researchanddesire/Open-Source-Wireless-Remote_RADR/hardware/cables/README.md

# RADR Cable Harnesses

Wireviz cable harness source files belong in this folder.

The product-level `hardware/bom.csv` should list each harness or cable as a
top-level assembly/device item. Detailed wire, connector, and child-part BOMs
should come from Wireviz-generated output when a harness source exists.
