researchanddesire/Open-Source-Wireless-Remote_RADR/hardware/cad/README.md

# RADR CAD

Mechanical source files and release exports for RADR belong in this folder.

Current migrated print files live under `hardware/Print Files/`. Future release
CAD exports should be placed here so the Ohai assembly-docs contract has the
standard `hardware/cad/`, `hardware/pcb/`, and `hardware/cables/` source
boundaries.
