researchanddesire/Open-Source-Wireless-Remote_RADR/assembly-docs/pcb-overview.mdx

---
title: PCB Overview
---

The source PCB design files live in [`hardware/pcb/`](https://github.com/researchanddesire/Open-Source-Wireless-Remote_RADR/tree/main/hardware/pcb/). The detailed PCB component BOM is tracked there and linked from the `RADR PCB assembly` line in the [Bill of Materials](/radr/bom).

| Asset | Link |
| ----- | ---- |
| PCB design files | [`hardware/pcb/RADR - PCB Design Files v0.4/`](https://github.com/researchanddesire/Open-Source-Wireless-Remote_RADR/tree/main/hardware/pcb/RADR%20-%20PCB%20Design%20Files%20v0.4/) |
| Board layout | [`PCB - OSSM Wireless v0.4.pcbdoc`](https://github.com/researchanddesire/Open-Source-Wireless-Remote_RADR/blob/main/hardware/pcb/RADR%20-%20PCB%20Design%20Files%20v0.4/PCB%20-%20OSSM%20Wireless%20v0.4.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) |
| Schematic PDF | [`RADR Schematic - OSSM Wireless V0.4.pdf`](https://github.com/researchanddesire/Open-Source-Wireless-Remote_RADR/blob/main/hardware/pcb/RADR%20Schematic%20-%20OSSM%20Wireless%20V0.4.pdf) |
| PCB render | [`RADR PCB render.png`](https://github.com/researchanddesire/Open-Source-Wireless-Remote_RADR/blob/main/hardware/pcb/RADR%20PCB%20render.png) |
| PCB component BOM | [`RADR BOM - OSSM Wireless - v0.4 - S3.xlsx`](https://github.com/researchanddesire/Open-Source-Wireless-Remote_RADR/blob/main/hardware/pcb/RADR%20BOM%20-%20OSSM%20Wireless%20-%20v0.4%20-%20S3.xlsx) |
