researchanddesire/Open-Source-Wireless-Remote_RADR/assembly-docs/pcb-overview.md

# PCB Overview

The source PCB design files live in [`hardware/pcb/`](../hardware/pcb/). The detailed PCB component BOM is tracked there and linked from the `RADR PCB assembly` line in the [Bill of Materials](bom.md).

| Asset | Link |
| ----- | ---- |
| PCB design files | [`hardware/pcb/RADR - PCB Design Files v0.4/`](../hardware/pcb/RADR%20-%20PCB%20Design%20Files%20v0.4/) |
| Board layout | [`PCB - OSSM Wireless v0.4.pcbdoc`](../hardware/pcb/RADR%20-%20PCB%20Design%20Files%20v0.4/PCB%20-%20OSSM%20Wireless%20v0.4.pcbdoc) |
| Schematic PDF | [`RADR Schematic - OSSM Wireless V0.4.pdf`](../hardware/pcb/RADR%20Schematic%20-%20OSSM%20Wireless%20V0.4.pdf) |
| PCB render | [`RADR PCB render.png`](../hardware/pcb/RADR%20PCB%20render.png) |
| PCB component BOM | [`RADR BOM - OSSM Wireless - v0.4 - S3.xlsx`](../hardware/pcb/RADR%20BOM%20-%20OSSM%20Wireless%20-%20v0.4%20-%20S3.xlsx) |
