researchanddesire/Open-Source-Wireless-Remote_RADR/developer-docs/docs/hardware/specifications/index.md

# RADR Hardware Specifications

Technical reference for power behavior, indicators, and feedback.

- [Battery and Power](/radr/hardware/specifications/battery-and-power/)
- [Feedback and Indicators](/radr/hardware/specifications/feedback-and-indicators/)
