researchanddesire/Open-Source-Wireless-Remote_RADR/CUTOVER.md

# Cutover checklist — RADR

RADR is already public under CERN-OHL-S. Cutover replaces the canonical repo with the restructured `RADR-OSS` fork.

Validate OTA at `https://researchanddesire.github.io/RADR-OSS/` before switch.

See [`dev-docs/CUTOVER.md`](https://github.com/researchanddesire/dev-docs/blob/main/CUTOVER.md).
