researchanddesire/Open-Source-Wireless-Remote_RADR/STAGING.md

# OSS staging — RADR-OSS

Canonical **`main`** on `radr-wireless-remote` continues normal development.

```bash
git fetch upstream main
git checkout opensource-prep
git rebase upstream/main
```

Set `upstream` to `https://github.com/researchanddesire/radr-wireless-remote.git`.
