researchanddesire/Open-Source-Wireless-Remote_RADR/developer-docs/docs/development/screen-capture.md

# Development display capture

Development profiles `development` enable the
read-only `screen` command on the normal 115200-baud USB serial port. Production
and staging profiles omit the console, its task and its capture memory.
Existing development aliases retain their behavior.

Build explicitly without uploading, from the repository root:

```sh
pio run -d software/firmware -e development -t buildprog
```

Use the enrolled device and its matching flash/PSRAM profile. Do not replace its
partition layout or erase NVS to take a screenshot. Close other serial monitors
and wait for a hardware-validation job to finish before opening its port. Keep
the device idle (and a Lockbox unlocked).

```sh
python -m pip install pyserial
python software/scripts/capture_screen.py --port COM_PORT --product RADR --output-dir captures --name current
```

Replace COM_PORT with the verified device port. Opening serial can reset some
boards; use `--startup-delay 10` if needed. Omit `--name` to keep one connection
open while navigating normally; type `capture menu` or `quit`. This works on
Windows and with piped commands. A single capture makes at most three requests and times out after 90 seconds. TFT captures take about 12 seconds; the UI continues updating during transmission.

The tool saves a PNG, little-endian RGB565 buffer, and JSON dimensions/checksums.
Rows carry a snapshot ID and RLE pixels; the complete frame must match the
device's FNV-1a checksum. Stale, duplicate or corrupted rows cannot produce an unchecked image. If USB drops bytes or logs
interrupt a transfer, screen retry retransmits the retained snapshot, even while
the UI changes. The reader releases it after success; an abandoned snapshot
expires after 90 seconds. Only snapshots with the same
product, dimensions and complete-image checksum can supply missing rows; the
combined pixels must still pass the checksum. Changed images never mix. Unrelated
device logs are ignored and never saved. Exhausted retries fail without saving.

TFT firmware mirrors drawing operations, including fast bitmap writes, in PSRAM.
OLED firmware copies its existing 1024-byte U8g2 buffer and translates its configured
rotation into the logical UI view. The display mutex is held only while copying;
serial transmission does not pause rendering. Development SDK logs use the
same serial writer to avoid splitting rows; ordinary and fault logs are retained. This captures the current pixel
buffer, not backlight brightness, panel faults, or an optical photograph. It does
not change product control protocols, pairing, calibration or saved credentials.

Do not commit captures: they may show device or account information. PR checks
compile every development variant and test rejection of damaged capture streams;
staging hardware evidence still uses the exact PR staging artifacts.
