researchanddesire/Open-Source-Wireless-Remote_RADR/developer-docs/docs/tools/web-flasher.md

# Web Flasher (RADR)

Use this tool for firmware recovery and manual flashing of your RADR. The Web Flasher runs directly in a Chromium-based browser (Chrome or Edge) and installs firmware over USB-C — no software installation required.

import { DeviceFlasher } from '/snippets/shared/device-flasher.jsx';

<DeviceFlasher />
