researchanddesire/Open-Source-Wireless-Remote_RADR/hardware/Photos/RADR main menu.webp

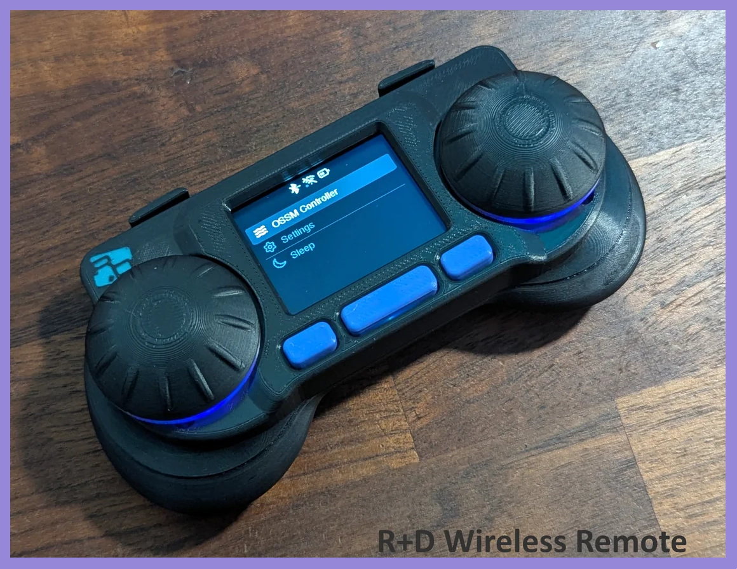
hardware/Photos/RADR main menu.webp
