researchanddesire/Open-Source-Wireless-Remote_RADR/assembly-docs/bom.mdx

---
title: Bill of Materials
showToc: false
---

The RADR wireless remote uses a custom populated PCB assembly, display, battery, 3D-printed enclosure parts, printed controls, weather stripping, and tri-lobe screws.

## Parts

This parts list is generated from [`hardware/bom.csv`](https://github.com/researchanddesire/Open-Source-Wireless-Remote_RADR/blob/main/hardware/bom.csv) during the assembly-docs build. Do not edit the generated table by hand. Update the CSV instead. Parts are referenced throughout the [Assembly Guide](/radr/assembly-guide).

import bom from "./_bom/bom.json";

<BillOfMaterials data={bom} />

## Assembly Tools and Shop Supplies

| Item | Use |
| ---- | --- |
| Rasp | Deburring the PCBA edge before enclosure fit-up. |
| T8 screwdriver bit | Installing tri-lobe enclosure screws. |
| Electric screwdriver or hand driver | Driving enclosure and battery-cover screws. |
| Isopropyl alcohol | Cleaning the PCBA before installing weather stripping. |
| Microfiber cloth | Cleaning the PCBA and protecting cosmetic surfaces. |
| Razor blade | Trimming the front-housing bumper features. |
| Hot glue gun | Securing the display into the front housing. |
| Small screwdriver | Opening the display ribbon connector and cleaning the knob bore. |
