researchanddesire/Open-Source-Wireless-Remote_RADR/developer-docs/docs/hardware/bom.md

# Bill of Materials (BOM)

If you're comfortable with electronics repair and want to source replacement components yourself (such as encoders, switches, or other parts), the Bill of Materials (BOM) contains manufacturer part numbers for all components.

**[RADR Bill of Materials](https://github.com/researchanddesire/Open-Source-Wireless-Remote_RADR/tree/main/hardware)**

Complete parts list with manufacturer part numbers and specifications.

The BOM Excel file (`RADR BOM - OSSM Wireless - v0.4 - S3.xlsx`) includes:

- Manufacturer part numbers
- Component values and specifications
- Quantity per board

!!! tip
    For common components like rotary encoders and tactile switches, you can often find equivalent parts at electronics suppliers like DigiKey, Mouser, or LCSC using the part numbers from the BOM.

If you'd prefer not to source parts yourself, [contact support](mailto:support@researchanddesire.com) and we can send replacement components or a replacement remote.
