researchanddesire/Open-Source-Wireless-Remote_RADR/developer-docs/docs/hardware/printed-parts/index.md

# RADR Printed Parts

Use these pages to identify, print, and troubleshoot each RADR printed component.

- [Remote Top](/radr/hardware/printed-parts/part-by-part/remote-top/)
- [Remote Bottom](/radr/hardware/printed-parts/part-by-part/remote-bottom/)
- [Remote Knob](/radr/hardware/printed-parts/part-by-part/remote-knob/)
- [Buttons](/radr/hardware/printed-parts/part-by-part/buttons/)
- [Power Switch](/radr/hardware/printed-parts/part-by-part/power-switch/)
- [OSSM Remote Clip](/radr/hardware/printed-parts/part-by-part/ossm-remote-clip/)
