researchanddesire/Open-Source-Wireless-Remote_RADR/developer-docs/docs/hardware/printed-parts/part-by-part/power-switch.md

# Power Switch Cap

import { STLViewer } from '/snippets/ossm/stl-render.jsx';

<STLViewer url="https://raw.githubusercontent.com/researchanddesire/Open-Source-Wireless-Remote_RADR/main/hardware/Print%20Files/Power%20Switch.stl" />

## Function

The Power Switch Cap is an optional decorative cover that fits over the power switch toggle. This component:

- Provides an aesthetically finished look to the power switch
- Sits over the existing switch toggle
- Purely cosmetic—not required for operation

## Print Settings

| Setting | Value |
|---|---|
| Layer Height | 0.12mm |
| Walls | 4 |
| Infill Type | Gyroid |
| Infill Percentage | 25% |
| Supports | None |

!!! tip
    This is a very small part. Print multiple copies or include it with other small parts like the buttons for efficiency.

## Installation

### Step 1: Print the cap

  Print the power switch cap using the settings above.

  !!! success
The cap is free of defects and has clean surfaces.

### Step 2: Press onto switch

  Gently press the cap onto the power switch toggle. It should friction-fit in place.

  !!! warning
Do not use adhesive unless the fit is too loose. A drop of CA glue can be used as a last resort.

### Step 3: Test operation

  Verify the switch still operates smoothly with the cap installed.

  !!! success
Switch toggles on/off with no binding or interference.

!!! info
    This part is optional. The remote functions perfectly without it—the power switch is fully usable as-is.

## Download Files
**[STEP File](https://github.com/researchanddesire/Open-Source-Wireless-Remote_RADR/blob/main/hardware/Print%20Files/Power%20Switch.step)**

Download for CAD editing

**[3MF Project](https://github.com/researchanddesire/Open-Source-Wireless-Remote_RADR/blob/main/hardware/Print%20Files/Bambu%20A1%20Remote_V1.01.3mf)**

Bambu Studio project with print settings
