researchanddesire/Open-Source-Wireless-Remote_RADR/developer-docs/docs/hardware/printed-parts/part-by-part/remote-bottom.md

# Remote - Bottom Housing

import { STLViewer } from '/snippets/ossm/stl-render.jsx';

<STLViewer url="https://raw.githubusercontent.com/researchanddesire/radr-wireless-remote/main/Hardware/Print%20Files/Remote%20-%20Bottom.stl" />

## Function

The Bottom Housing is the lower shell of the RADR wireless remote. This component:

- Forms the battery compartment for the rechargeable battery
- Provides the rear ergonomic surface for comfortable grip
- Contains mounting bosses for PCB attachment
- Features the USB-C charging port access
- Mates with the Top Housing to complete the enclosure

## Print Settings

| Setting | Value |
|---|---|
| Layer Height | 0.12mm (for smooth curves) |
| Walls | 4 |
| Infill Type | Gyroid |
| Infill Percentage | 20-30% |
| Supports | Yes - for internal features |

!!! tip
    Print with the interior facing up to ensure clean exterior surfaces.

## Assembly Notes

### Step 1: Check fit

  Test fit the PCB and battery before final assembly. Verify the USB-C port aligns with the housing opening.
  
  !!! success
The PCB sits flat on the mounting bosses with no interference.

### Step 2: Verify clearances

  Ensure the battery fits with adequate clearance. Some printer tolerances may require light sanding.
  
  !!! warning
Do not force components. If fit is too tight, sand lightly rather than applying excessive force.

## Download Files
**[STEP File](https://github.com/researchanddesire/radr-wireless-remote/blob/main/Hardware/Print%20Files/Remote%20-%20Bottom.step)**

Download for CAD editing

**[3MF Project](https://github.com/researchanddesire/radr-wireless-remote/blob/main/Hardware/Print%20Files/Bambu%20A1%20Remote_V1.01.3mf)**

Bambu Studio project with print settings
