researchanddesire/Open-Source-Wireless-Remote_RADR/hardware/pcb/RADR BOM - OSSM Wireless - v0.4 - S3.xlsx

Quantity | Designator | Footprint | Value | Manufacturer Part | Manufacturer
1 | Blue_Charge | LED-SMD_L1.7-W0.6-RD |  | TJ-S1706SW6TGLC6B-A5 | TOGIALED(统佳)
1 | BUZZER1 | BUZ-SMD_L4.0-W4.0-P3.50-L | 4kHz | FUET-4020 | FUET(福声科技)
7 | C6,C8,C23,C24,C25,C26,C35 | C0402 | 10uF | GRM155R61A106ME44D | muRata(村田)
5 | C9,C11,C15,C16,C17 | C0402 | 100nF | CL05A104KA5NNNC | SAMSUNG(三星)
2 | C10,C27 | C0402 | 1uF | CL05A105KA5NQNC | SAMSUNG(三星)
1 | C14 | C0402 | 10uF | CL05A106MP5NUNC | SAMSUNG(三星)
3 | C18,C19,C20 | C0402 | 2.2uF | CL05A225KO5NQNC | SAMSUNG(三星)
5 | C28,C29,C30,C32,C33 | C1206 | 100uF | GRM31CR60J107ME39L | muRata(村田)
1 | C34 | C0402 | 10nF | CC0402KRX7R5BB103 | YAGEO(国巨)
2 | D1,D2 | SOD-123F_L2.7-W1.6-LS3.8-RD-1 |  | B5819W | GOODWORK(固得沃克)
1 | D3 | SOD-123_L2.8-W1.8-LS3.7-RD |  | B5819W-TP | MCC(美微科)
2 | ENC_L,ENC_R | SW-TH_EC12EXXXX |  | EC12E24204A8 | ALPSALPINE(阿尔卑斯阿尔派)
3 | ESP,External,Internal | SOT-23-5_L3.0-W1.7-P0.95-LS2.8-BL |  | ME6211C33M5G-N | MICRONE(南京微盟)
1 | Green_Power | LED-SMD_L1.7-W0.6-RD |  | TJ-S1706SW6TGLC2G-A5 | TOGIALED(统佳)
5 | LS_1,LS_2,RESET,RS_1,RS_2 | SW-SMD_TS24CA |  | TS24CA | SHOU HAN(首韩)
1 | M1 | VIBRATING-MOTOR-SMD_3P-C9900001680 |  | Z3OC1T8219731 | KOTL(金龙机电)
2 | P-UP-1,P-UP-2 | SW-SMD_2P-L6.2-W2.5-LS9.4 |  | 2.54-1P TPGT | SHOU HAN(首韩)
1 | POWERSW | SW-TH_SK12D07VG5 |  | SK12D07VG5 | SHOU HAN(首韩)
3 | Q1,Q2,Q3 | SOT-23_L2.9-W1.3-P1.90-LS2.4-BR |  | AO3400 | GOODWORK(固得沃克)
2 | Q5,Q6 | SOT-23-3_L2.9-W1.3-P1.90-LS2.4-BR |  | BC817 | CJ（江苏长电/长晶）
1 | Q7 | SOT-23-3_L2.9-W1.4-P1.91-LS2.6-BR |  | SI2301 | TWGMC(台湾迪嘉)
1 | QWIIC | CONN-SMD_4P-P1.00_SM04B-SRSS-TB-LF-SN |  | SM04B-SRSS-TB(LF)(SN) | JST
1 | R1 | R0603 | 10Ω | PS03W4F100JT5E | UNI-ROYAL(厚声)
3 | R7,R8,R26 | R0402 | 10kΩ | WR04X1002FTL | 华新科(Walsin)
2 | R9,R10 | R0402 | 100Ω | RC0402FR-07100RL | YAGEO(国巨)
2 | R11,R16 | R0402 | 1kΩ | RC0402FR-071KL | YAGEO(国巨)
1 | R18 | R0402 | 2kΩ | RC0402FR-072KL | YAGEO(国巨)
1 | R19 | R0402 | 330Ω | RC0402FR-07330RL | YAGEO(国巨)
2 | R20,R21 | R0402 | 5.1kΩ | 0402WGF5101TCE | UNI-ROYAL(厚声)
8 | R22,R23,R24,R25,R32,R35,R36,R39 | R0402 | 10kΩ | RC0402FR-0710KL | YAGEO(国巨)
1 | R34 | R0402 | 5.1kΩ | RC0402FR-075K1L | YAGEO(国巨)
2 | R40,R41 | R0402 | 4.7kΩ | 0402WGJ0472TCE | UNI-ROYAL(厚声)
1 | SCREEN | FPC-SMD_AFC01-S14FCA-00 |  | AFC01-S14FCA-00 | JS(钜硕电子)
3 | U1,U2,U3 | LED-SMD_4P-L1.0-W1.0-TL_XL-1010RGBC-WS2812B |  | XL-1010RGBC-WS2812B | XINGLIGHT(成兴光)
1 | U5 | LGA-14_L3.0-W2.5-P0.50-TL |  | LSM6DS3TR-C | ST(意法半导体)
1 | U6 | SOT-23-5_L3.0-W1.7-P0.95-LS2.8-BL |  | TP4054-42-SOT25R | TOPPOWER(南京拓微)
1 | U8 | CONN-TH_S2B-PH-K-LF-SN |  | S2B-PH-K(LF)(SN) | JST
1 | U9 | WQFN-28_L5.0-W5.0-P0.50-BL-EP3.2 |  | CP2102-GMR | SILICON LABS(芯科)
1 | U14 | DFN-8_L2.0-W2.0-P0.50-BL-EP |  | MAX17048G+T10 | ADI(亚德诺)/MAXIM(美信)
1 | U15 | WIRELM-SMD_ESP32-S3-WROOM-1 |  | ESP32-S3-WROOM-1-N16R8 | ESPRESSIF(乐鑫)
1 | U16 | SOIC-8_L5.0-W4.0-P1.27-LS6.0-BL |  | AT24C04C-SSHM-T | MICROCHIP(美国微芯)
1 | USBC1 | USB-C_SMD-TYPE-C-31-M-12 |  | TYPE-C-31-M-12 | 韩国韩荣
4 | US_L,US_M_1,US_M_2,US_R | SW-TH_4P-L5.0-W5.0-P4.50-LS6.5 |  | TC-6610-9-260G | HCTL(华灿天禄)
