researchanddesire/Open-Source-Wireless-Remote_RADR/hardware/radr/Wireless Remote BoM (RADR).xlsx

Part | QTY | Part number
Hardware
Tri lobe screws | 5 | 0408LTFB
Screen | 1 | IPS 2.0 inch 14PIN SPI LCD Display ST7789 240(RGB)*320
Battery | 1 | 3.7V 800mAh Lipo 802735
PCB | 1 | RADR-PCB-V0.4
Printed
Front housing | 1
Back housing | 1
Battery flap | 1
Side button | 2
Middle button | 1
Power slider button | 1
Knobs | 2
