researchanddesire/Open-Source-Wireless-Remote_RADR/hardware/Print Files/Power Switch.step

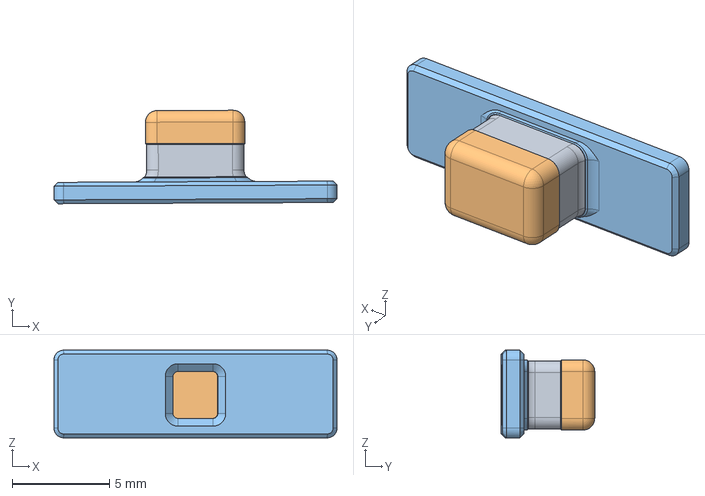
[picture p2: CAD file, 2026-10-20]
hardware/Print Files/Power Switch.step
14.5 x 4.80 x 4.50 mm
