researchanddesire/Open-Source-Wireless-Remote_RADR/hardware/Print Files/Remote - Knob.stl

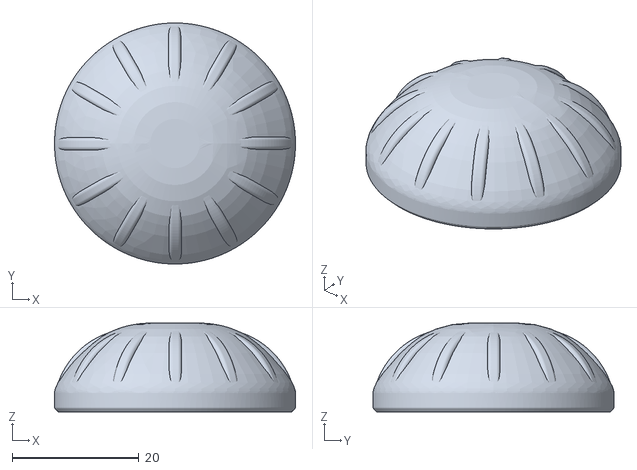
[picture p3: CAD file, 2026-10-20]
hardware/Print Files/Remote - Knob.stl
38.0 x 38.0 x 14.0
