researchanddesire/Open-Source-Wireless-Remote_RADR/hardware/Print Files/Bambu A1 Remote_V1.01.3mf

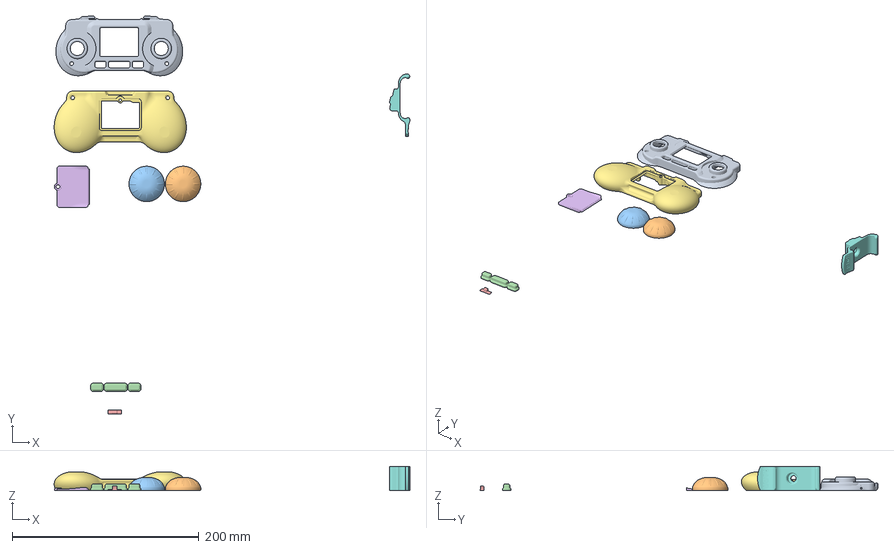
[picture p4: CAD file, 2026-10-20]
hardware/Print Files/Bambu A1 Remote_V1.01.3mf
381.2 x 426.6 x 26.0 mm
Remote - Top V1.01.step
Remote - Knob - Raised Bridges (OG Notch).step x 2
Buttons.step
Power Switch.step
Remote - Battery Cover.step
Remote - Bottom Housing
OSSM Remote Clip - Extrusion Bottom Release (M6x12).step
