researchanddesire/Open-Source-Wireless-Remote_RADR/hardware/Print Files/Remote - Bottom.step

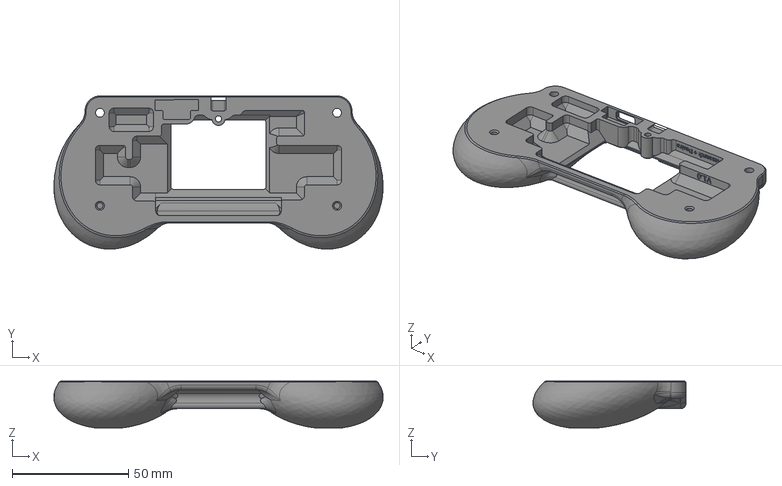
[picture p5: CAD file, 2026-10-20]
hardware/Print Files/Remote - Bottom.step
141.5 x 65.9 x 20.2 mm
ChargePower Light
Rear
