researchanddesire/Open-Source-Wireless-Remote_RADR/hardware/Print Files/Remote - Top V1.01.stl

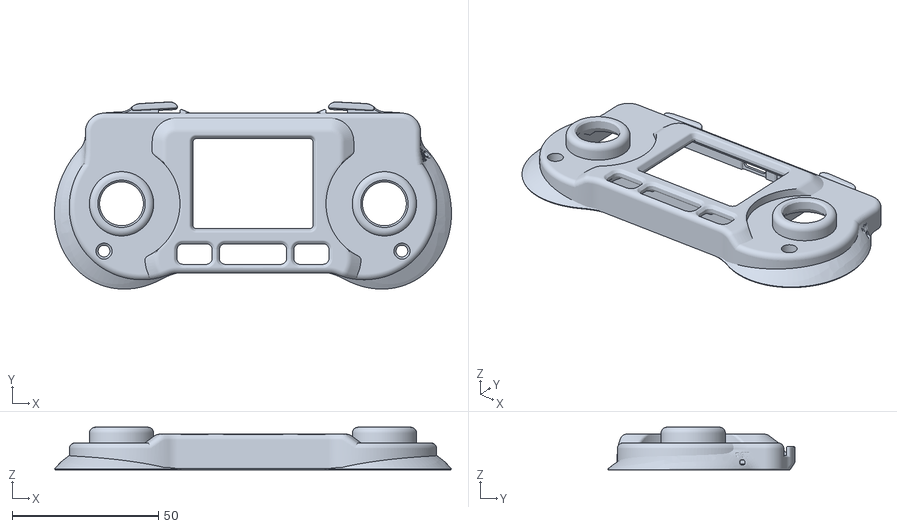
[picture p6: CAD file, 2026-10-20]
hardware/Print Files/Remote - Top V1.01.stl
135.9 x 64.1 x 14.6
