researchanddesire/Open-Source-Wireless-Remote_RADR/(list of files, cad)

Other CAD files:
hardware/radr/Print Files/Power Switch.stl
hardware/Print Files/Remote - Bottom.stl
