researchanddesire/Open-Source-Wireless-Remote_RADR/assembly-docs/assembly-guide.mdx

---
title: RADR Wireless Remote Assembly Guide
---

## Purpose

This work instruction documents the current RADR wireless remote assembly process from prepared PCB and printed parts through final device test.

Use these instructions with the active PCB, printed parts, and BOM release for the build.

## Required Parts and Consumables

1. Gather the required parts before starting assembly.

2. Confirm the assembly set includes:

    - `RADR-PCB-assembly`
    - `screen`
    - `battery`
    - `front-housing`
    - `back-housing`
    - `battery-flap`
    - 2x `side-button`
    - `middle-button`
    - `power-slider-button`
    - `knob`
    - `weather-stripping`
    - 5x `BC-0408LTFB` tri-lobe screws
    - `hot-glue`

3. If all required parts are present, continue onward.

## Tools

- Rasp
- T8 bit for tri-lobe screws
- Electric screwdriver or hand driver
- Isopropyl alcohol
- Microfiber cloth
- Razor blade
- Hot glue gun
- Small screwdriver

## Prepare the PCBA

1. Deburr the edges of the `RADR-PCB-assembly` with a rasp until the board edge is smooth.

    <Photo caption="Deburr the PCBA edges until smooth." style={{ maxWidth: "520px", margin: "0.75rem 0 1.5rem 1.5rem" }}>
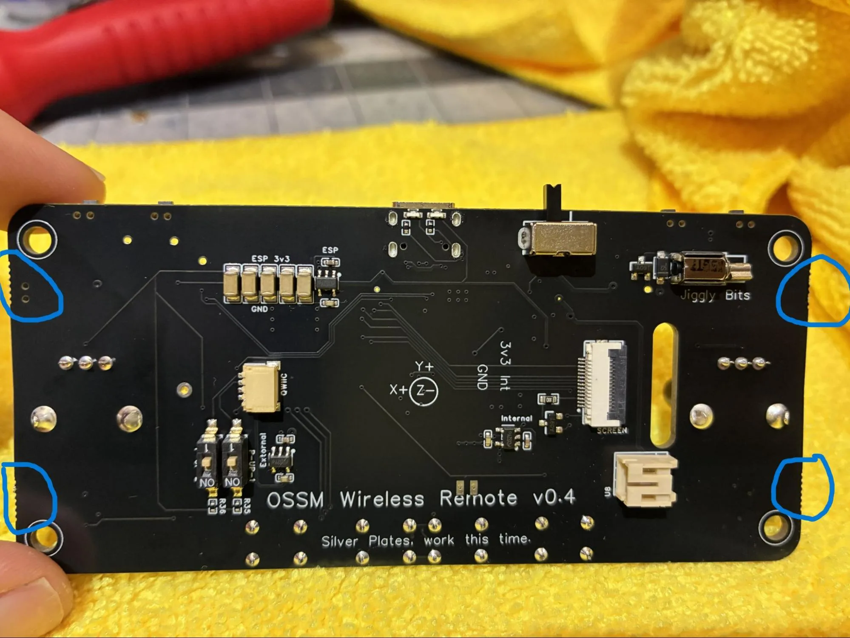
[picture p7: assembly-docs/assets/pcba-deburr-edges.webp]
RADR PCB assembly with edge areas marked for deburring
      
    </Photo>

2. Wipe the marked weather-strip area on the PCBA with `isopropyl-alcohol` and a `microfiber-cloth`.

    <Photo caption="Clean the marked weather-strip area." style={{ maxWidth: "520px", margin: "0.75rem 0 1.5rem 1.5rem" }}>
      Marked weather-strip area on the RADR PCB assembly
    </Photo>

3. Attach a 2.5 cm piece of `weather-stripping` to the center of the cleaned area.

    <Photo caption="Weather stripping installed on the PCBA." style={{ maxWidth: "520px", margin: "0.75rem 0 1.5rem 1.5rem" }}>
      Weather stripping installed on the RADR PCB assembly
    </Photo>

4. Fit the printed `power-slider-button` over the PCBA on/off switch.

    <Photo caption="Power switch cover installed." style={{ maxWidth: "520px", margin: "0.75rem 0 1.5rem 1.5rem" }}>
      Printed power switch cover installed over the PCBA on off switch
    </Photo>

5. Connect the 800 mAh LiPo `battery` to the PCBA.

    Keep the PCBA switched off after connecting the battery. The PCBA produces a green light when powered on and does not produce that light when switched off.

    <Photo caption="Battery connected to the PCBA." style={{ maxWidth: "520px", margin: "0.75rem 0 1.5rem 1.5rem" }}>
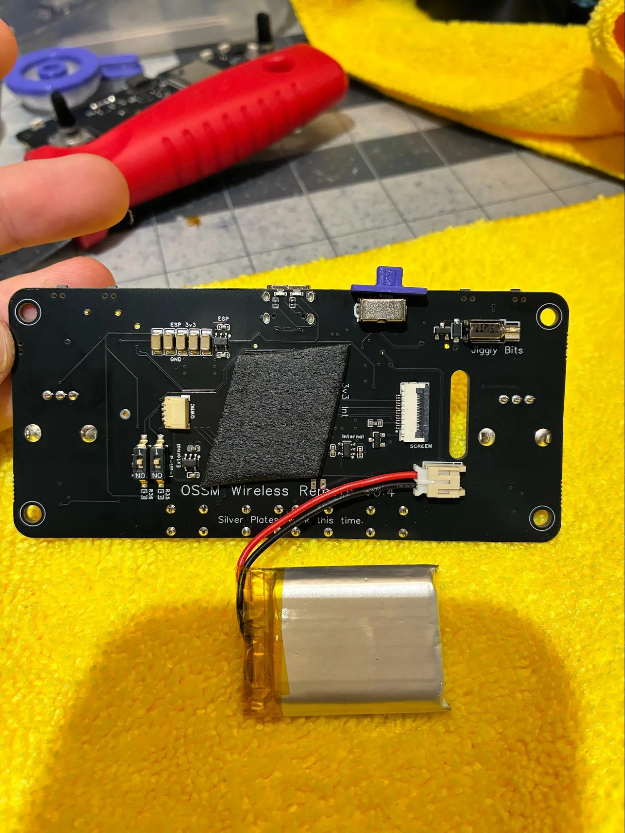
[picture p8: assembly-docs/assets/battery-connected-to-pcba.webp]
LiPo battery connected to the RADR PCB assembly
      
    </Photo>

6. Confirm the PCBA is deburred, padded, fitted with the power switch cover, connected to the battery, and switched off before continuing.

## Prepare the Front Housing

1. Use a `razor-blade` to cut a small triangle off both bumpers on the `front-housing`.

    These cuts stop the bumpers from catching on the PCBA during installation.

    <PhotoGrid>
      <Photo caption="Trim both bumper features." style={{ maxWidth: "360px", margin: "0" }}>
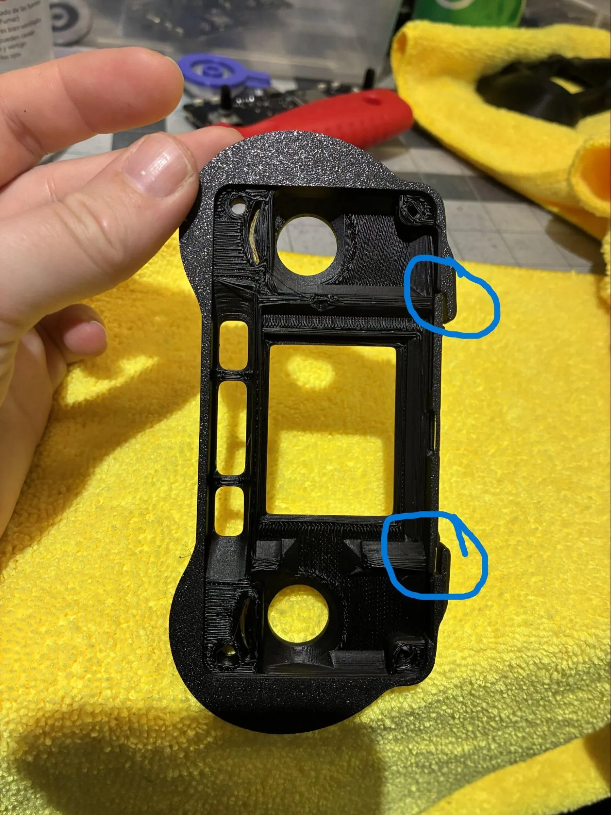
[picture p9: assembly-docs/assets/front-housing-bumper-cut-lines.webp]
Front housing bumper features marked for trimming
      
    </Photo>
      <Photo caption="Trimmed interior bumper reference." style={{ maxWidth: "360px", margin: "0" }}>
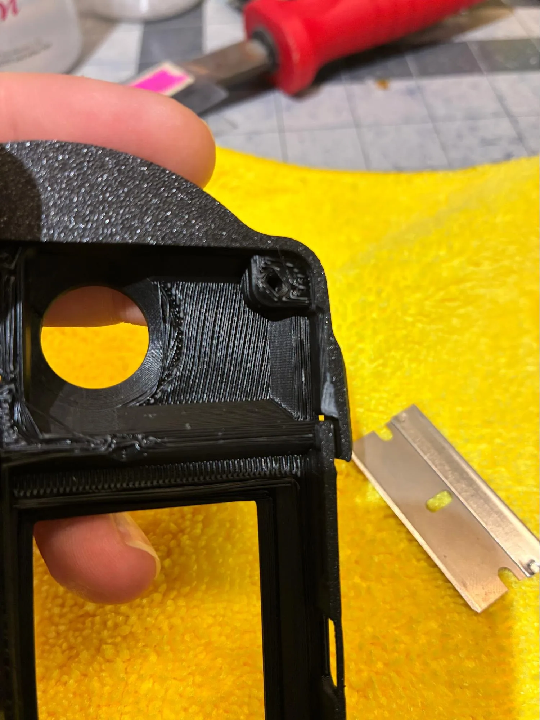
[picture p10: assembly-docs/assets/front-housing-bumper-trimmed.webp]
Front housing bumper after trimming
      
    </Photo>
    </PhotoGrid>

2. Remove the protective film from the `screen`.

    <Photo caption="Remove the display film." style={{ maxWidth: "520px", margin: "0.75rem 0 1.5rem 1.5rem" }}>
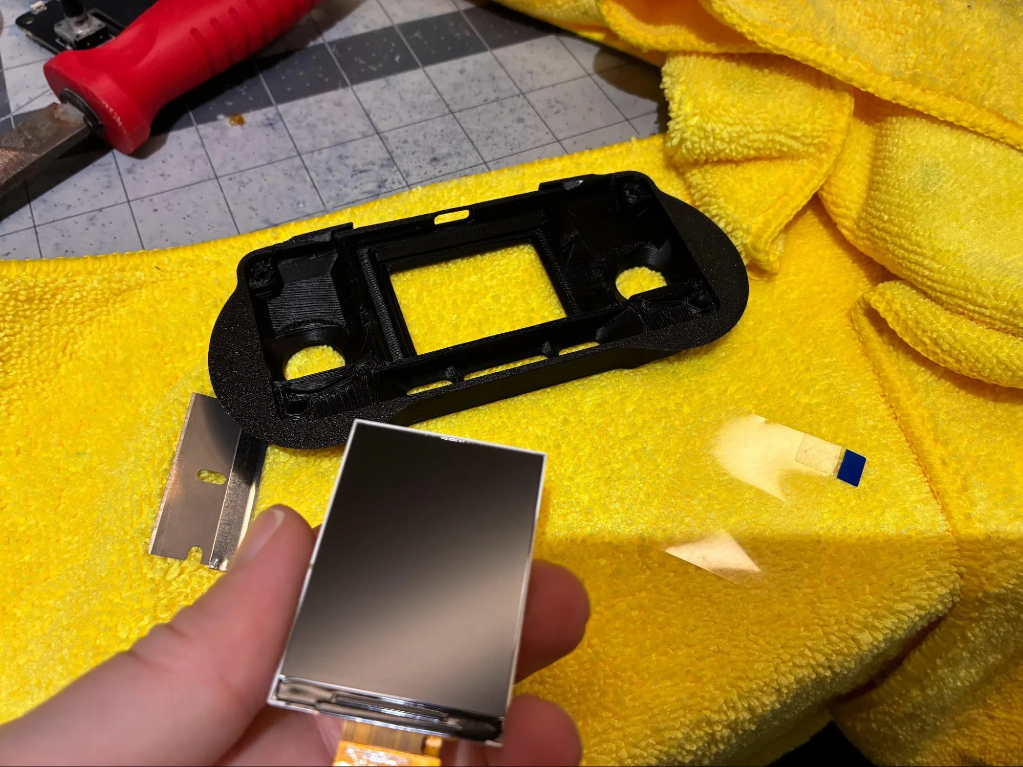
[picture p11: assembly-docs/assets/screen-protective-film-removal.webp]
Protective film being removed from the RADR display
      
    </Photo>

3. Install the `screen` into the `front-housing`.

    Insert the screen into the bottom lip of the interior front housing first. Gently flex the housing outward while pressing the screen into the upper screen lip. Confirm the screen is flush against the housing.

    <PhotoGrid>
      <Photo caption="Insert the screen into the bottom lip first." style={{ maxWidth: "360px", margin: "0" }}>
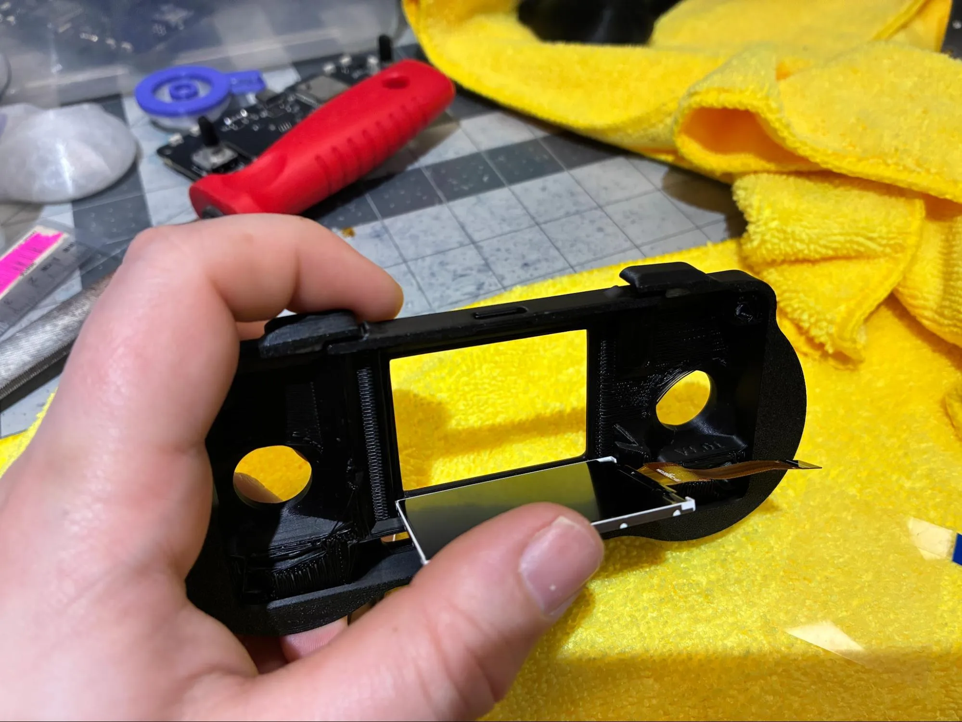
[picture p12: assembly-docs/assets/screen-bottom-lip-insertion.webp]
Display being inserted into the lower lip of the RADR front housing
      
    </Photo>
      <Photo caption="Screen seated flush in the housing." style={{ maxWidth: "360px", margin: "0" }}>
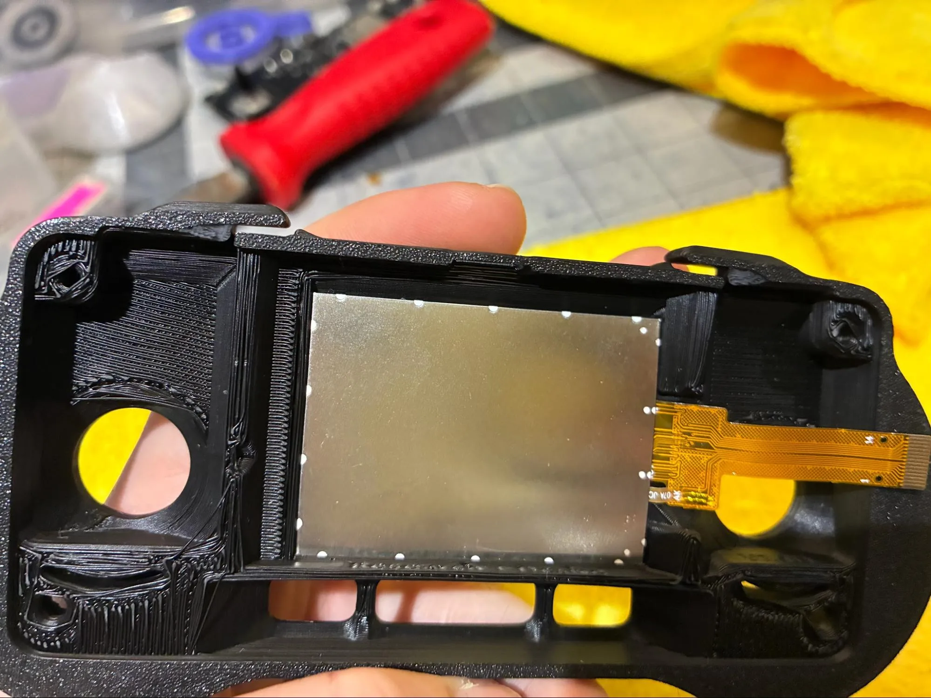
[picture p13: assembly-docs/assets/screen-seated-flush.webp]
Display seated flush in the RADR front housing
      
    </Photo>
    </PhotoGrid>

4. Run a thin, low-profile bead of `hot-glue` along the screen edges.

    Keep the glue bead in contact with both the screen edge and the plastic housing. The housing plastic should melt slightly into the glue.

    <Photo caption="Low-profile glue bead around the screen edge." style={{ maxWidth: "520px", margin: "0.75rem 0 1.5rem 1.5rem" }}>
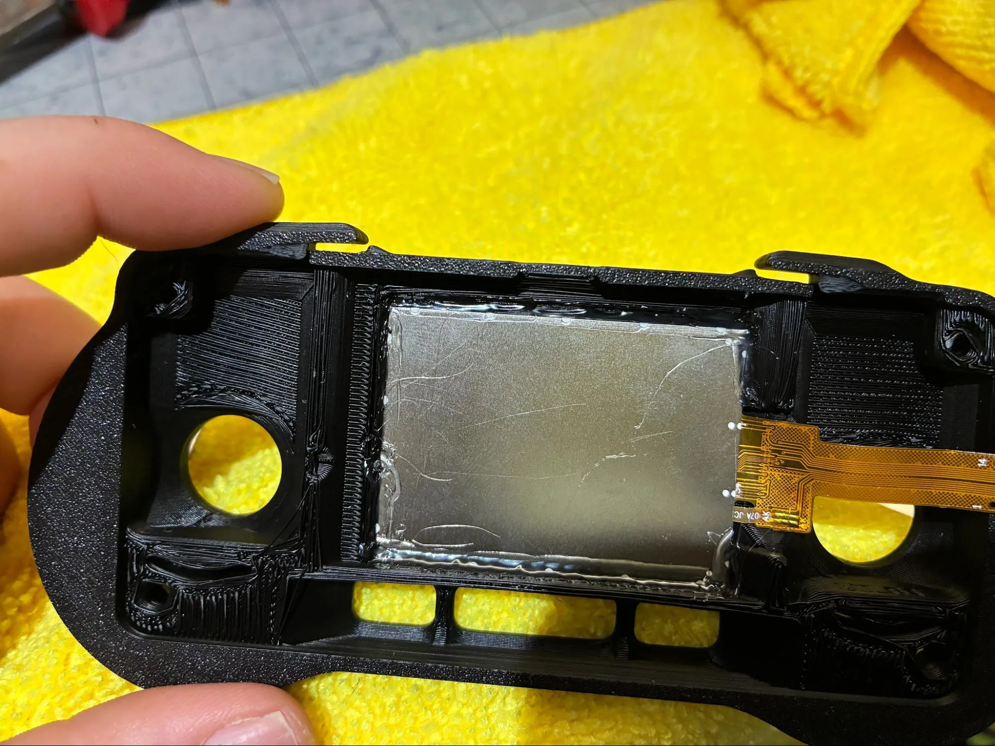
[picture p14: assembly-docs/assets/screen-hot-glue-bead.webp]
Hot glue bead around the RADR display edge
      
    </Photo>

5. Drop the printed buttons into the `front-housing`.

    <Photo caption="Buttons installed in the front housing." style={{ maxWidth: "520px", margin: "0.75rem 0 1.5rem 1.5rem" }}>
      Printed RADR buttons installed in the front housing
    </Photo>

6. Confirm the bumpers are trimmed, the screen is glued in place, and the buttons move freely before continuing.

## Install the PCBA

1. Feed the screen ribbon through the cutout in the PCBA, then press the PCBA flush into the `front-housing`.

    <Photo caption="PCBA seated in the front housing." style={{ maxWidth: "520px", margin: "0.75rem 0 1.5rem 1.5rem" }}>
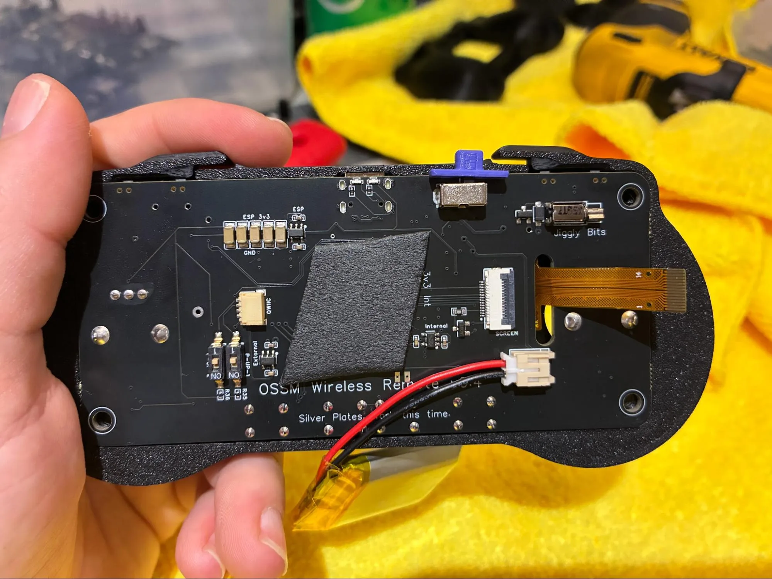
[picture p15: assembly-docs/assets/pcba-seated-in-front-housing.webp]
RADR PCB assembly seated in the front housing with screen ribbon routed through the PCB cutout
      
    </Photo>

2. Open the screen ribbon connector on the PCBA with a small screwdriver.

    <Photo caption="Open the screen connector." style={{ maxWidth: "520px", margin: "0.75rem 0 1.5rem 1.5rem" }}>
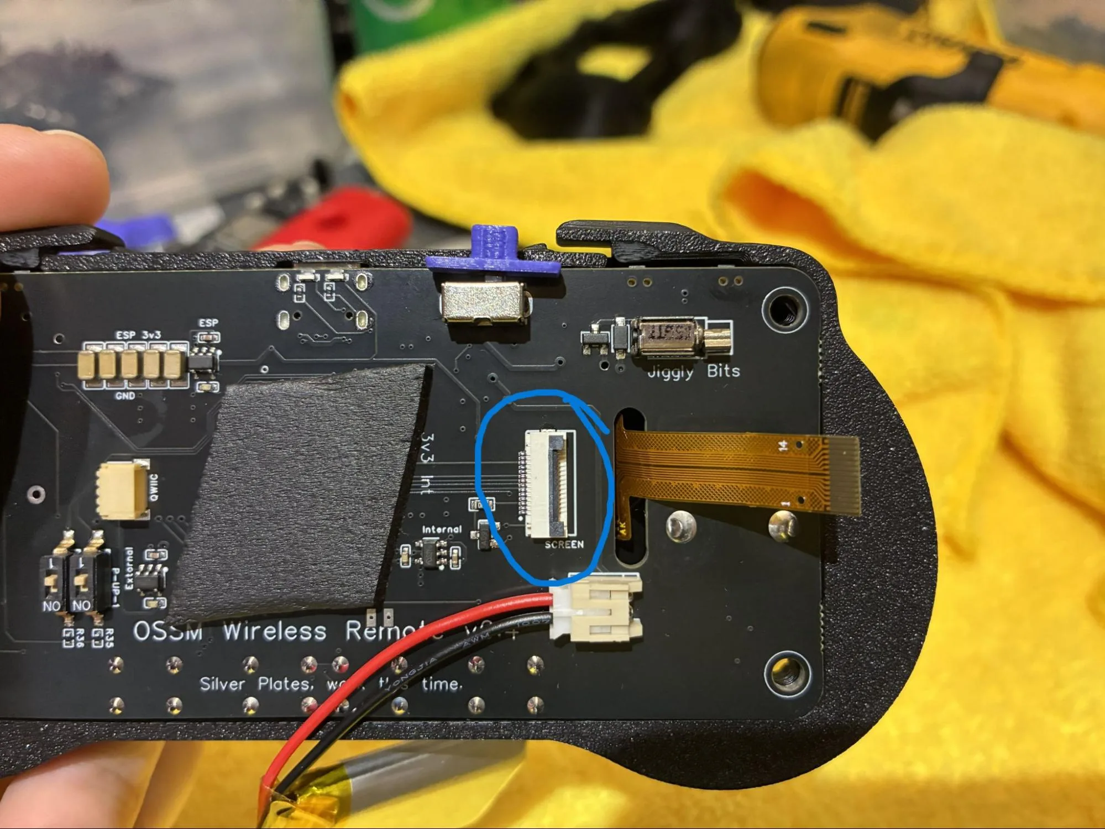
[picture p16: assembly-docs/assets/screen-connector-open.webp]
Open screen ribbon connector on the RADR PCB assembly
      
    </Photo>

3. Insert the screen ribbon into the connector and close the connector.

    <Photo caption="Screen ribbon connected." style={{ maxWidth: "520px", margin: "0.75rem 0 1.5rem 1.5rem" }}>
      Screen ribbon inserted into the RADR PCB connector
    </Photo>

4. Tuck the screen ribbon into the housing.

    <Photo caption="Screen ribbon tucked into the housing." style={{ maxWidth: "520px", margin: "0.75rem 0 1.5rem 1.5rem" }}>
      Screen ribbon tucked into the RADR housing
    </Photo>

5. Confirm the PCBA sits flush, the ribbon connector is closed, and the ribbon is tucked away from pinch points before continuing.

## Close the Housing

1. Place the `back-housing` over the `front-housing` by inserting the on/off switch into its cutout.

    <Photo caption="Align the power switch with the back-housing cutout." style={{ maxWidth: "420px", margin: "0.75rem 0 1.5rem 1.5rem" }}>
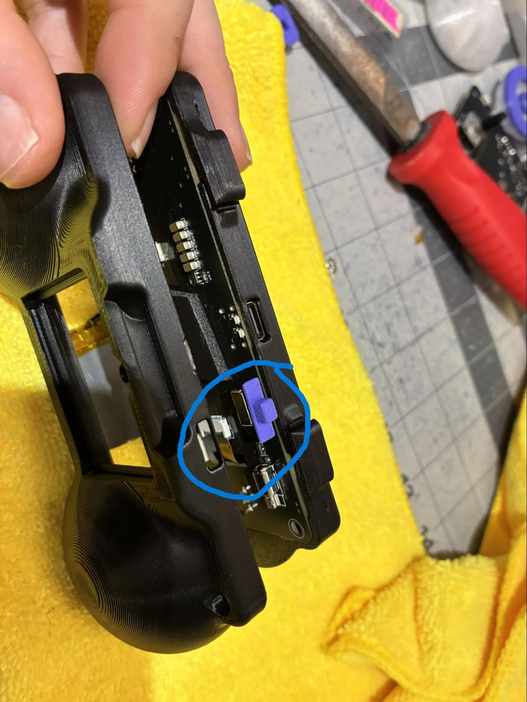
[picture p17: assembly-docs/assets/bottom-housing-power-switch-alignment.webp]
RADR back housing aligned over the front housing with the power switch entering its cutout
      
    </Photo>

2. Pull the `battery` through the open space in the back housing that will become the battery compartment.

    <PhotoGrid>
      <Photo caption="Pull the battery through the battery compartment opening." style={{ maxWidth: "360px", margin: "0" }}>
      Battery pulled through the RADR back housing battery compartment opening
    </Photo>
      <Photo caption="Battery routing reference." style={{ maxWidth: "360px", margin: "0" }}>
      Battery routing reference with RADR front and back housings partially closed
    </Photo>
    </PhotoGrid>

3. Using a medium torque setting, fasten the front and back housings together with tri-lobe screws.

    The screw is deep enough when the screwdriver ratchets.

    <Photo caption="Fasten the rear housing screws." style={{ maxWidth: "520px", margin: "0.75rem 0 1.5rem 1.5rem" }}>
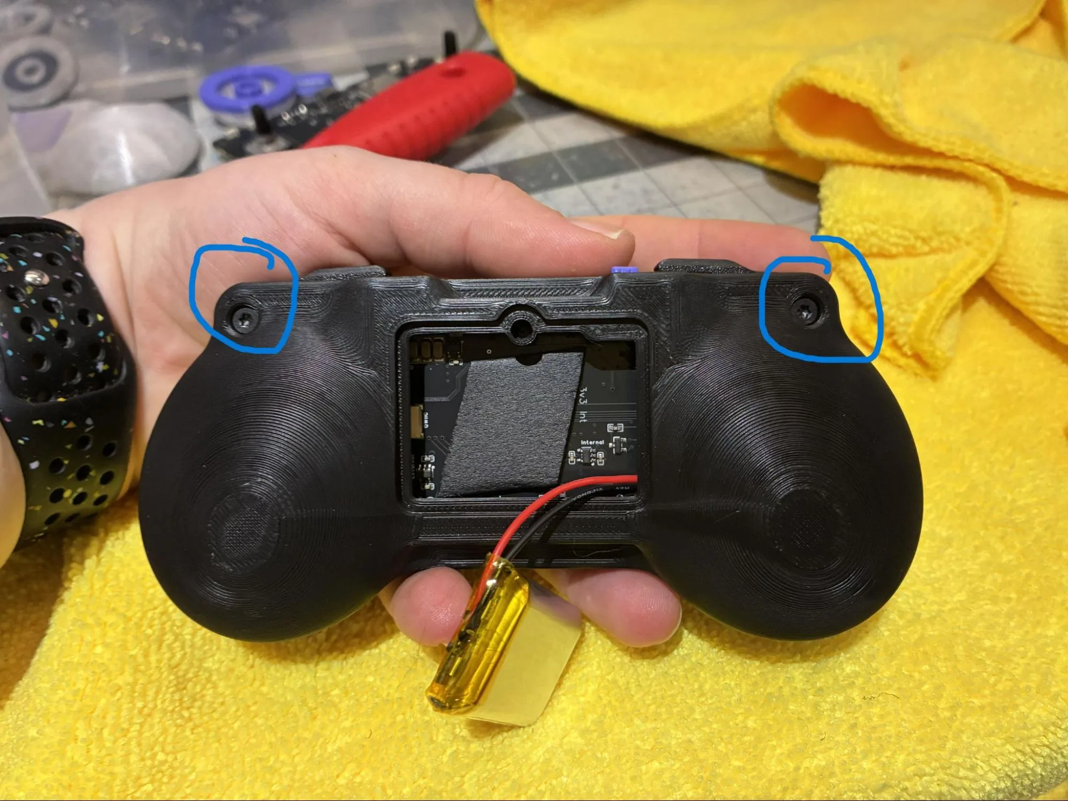
[picture p18: assembly-docs/assets/rear-screws-fastened.webp]
RADR rear housing screw locations fastened with tri-lobe screws
      
    </Photo>

4. Fasten the front-housing screw holes with the same tri-lobe screws.

    <Photo caption="Fasten the front housing screws." style={{ maxWidth: "420px", margin: "0.75rem 0 1.5rem 1.5rem" }}>
      RADR front housing screw locations fastened with tri-lobe screws
    </Photo>

5. Place the `battery` inside the battery compartment.

    <Photo caption="Battery placed in the compartment." style={{ maxWidth: "420px", margin: "0.75rem 0 1.5rem 1.5rem" }}>
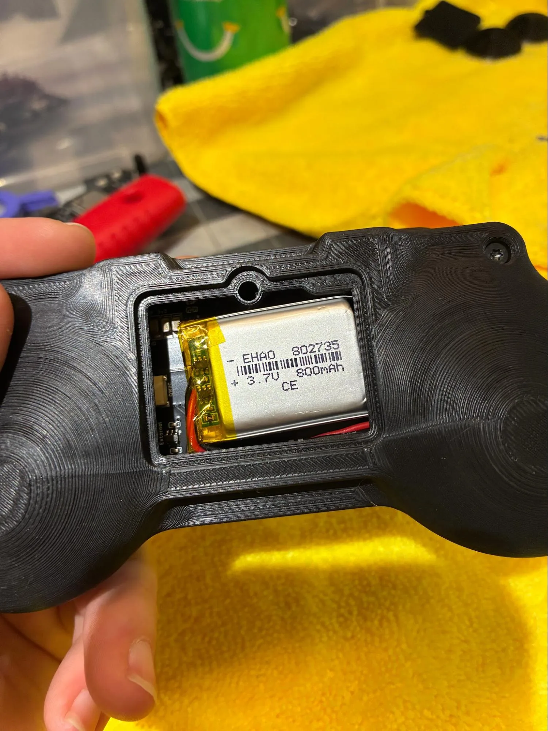
[picture p19: assembly-docs/assets/battery-in-compartment.webp]
RADR battery placed inside the battery compartment
      
    </Photo>

6. Place the `battery-flap` over the battery and screw it shut with tri-lobe screws.

    <Photo caption="Battery cover installed." style={{ maxWidth: "520px", margin: "0.75rem 0 1.5rem 1.5rem" }}>
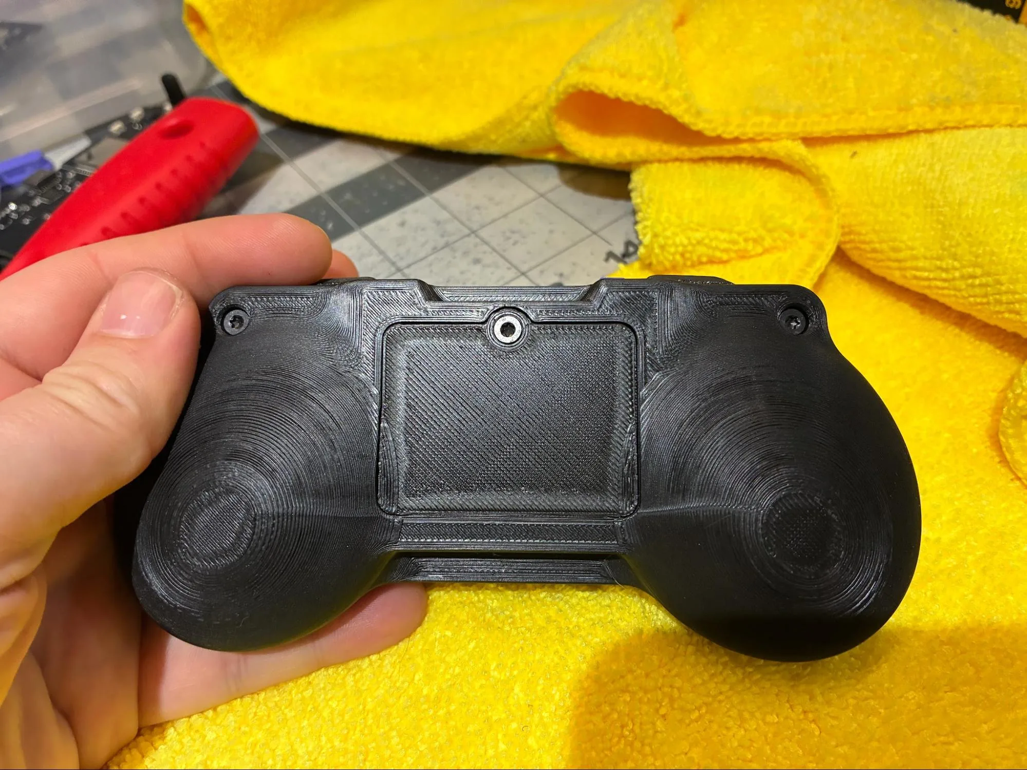
[picture p20: assembly-docs/assets/battery-cover-installed.webp]
RADR battery cover installed over the battery compartment
      
    </Photo>

7. Confirm the housing is fully closed, all screws are seated, and the battery cover is secured before continuing.

## Install Knob and Test

1. Use a small screwdriver to clean any excess filament from the interior knob circle.

    <Photo caption="Clean the knob bore before installation." style={{ maxWidth: "520px", margin: "0.75rem 0 1.5rem 1.5rem" }}>
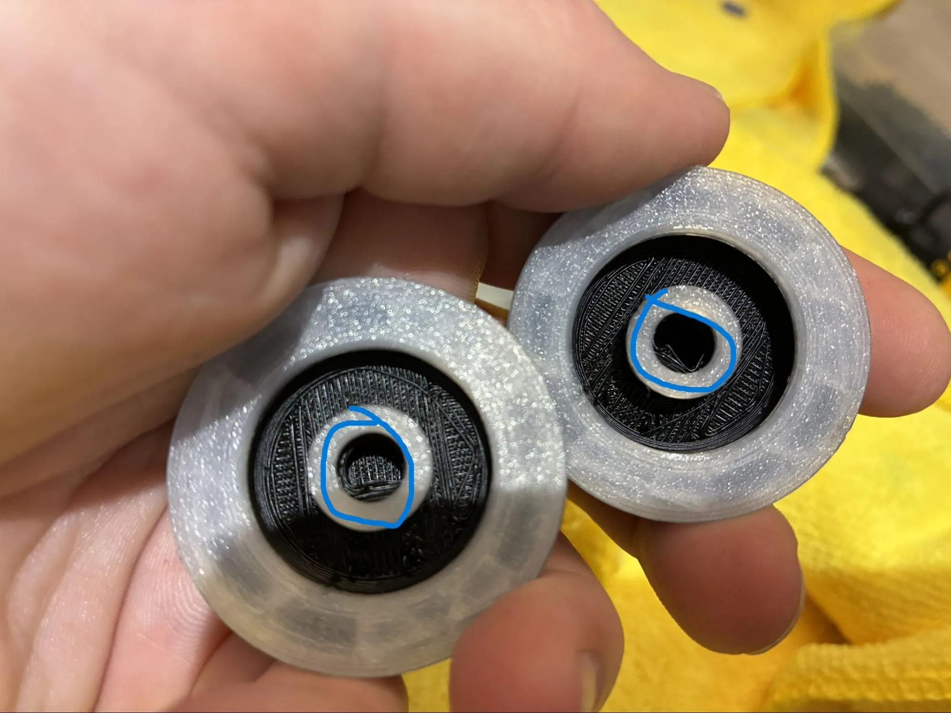
[picture p21: assembly-docs/assets/knob-interior-cleaned.webp]
Interior bore of the RADR knob after cleaning excess filament
      
    </Photo>

2. Align the encoder shape with the interior knob circle shape and press the `knob` onto the encoder until it softly clicks.

    <Photo caption="Press the knob onto the encoder." style={{ maxWidth: "520px", margin: "0.75rem 0 1.5rem 1.5rem" }}>
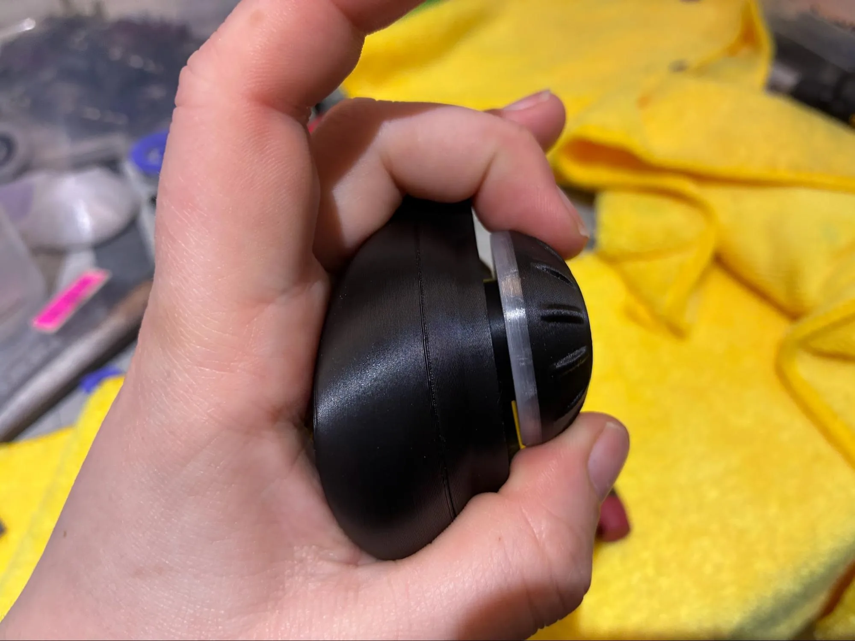
[picture p22: assembly-docs/assets/knob-installed-on-encoder.webp]
RADR knob being pressed onto the rotary encoder
      
    </Photo>

3. Turn on the device and test as per protocol.

    <Photo caption="Device powered on for final test." style={{ maxWidth: "520px", margin: "0.75rem 0 1.5rem 1.5rem" }}>
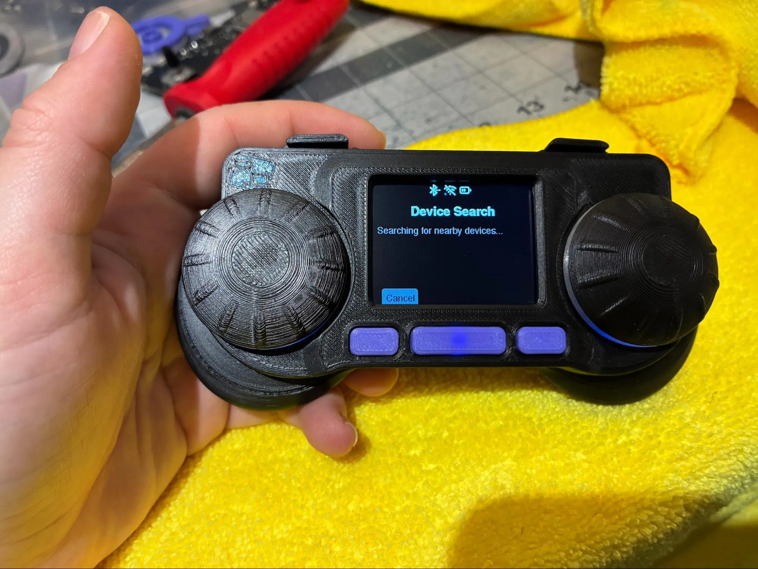
[picture p23: assembly-docs/assets/device-test-on.webp]
RADR wireless remote powered on for final test
      
    </Photo>

## Final Assembly

1. Confirm the PCBA edges are smooth and do not catch on the housing.
2. Confirm the weather stripping is centered and adhered to the PCBA.
3. Confirm the power switch cover moves the on/off switch cleanly.
4. Confirm the front-housing bumpers are trimmed.
5. Confirm the screen is flush and glued with a low-profile bead.
6. Confirm the buttons are installed and move freely.
7. Confirm the PCBA sits flush in the front housing.
8. Confirm the screen ribbon is fully inserted and the connector is closed.
9. Confirm the screen ribbon and battery wires are routed away from pinch points.
10. Confirm the housings and battery cover are fastened with tri-lobe screws.
11. Confirm the knob is seated on the encoder.
12. Confirm the device powers on and passes the current functional test protocol.

## QC Checklist

- [ ] PCBA edges were deburred until smooth.
- [ ] Weather-strip area was cleaned with isopropyl alcohol.
- [ ] 2.5 cm weather-strip piece was installed on the PCBA.
- [ ] Printed power switch cover was installed.
- [ ] Battery was connected with the PCBA switched off.
- [ ] Front-housing bumpers were trimmed.
- [ ] Screen film was removed.
- [ ] Screen was installed flush in the front housing.
- [ ] Screen was secured with a thin, low-profile hot glue bead.
- [ ] Buttons were dropped into the front housing.
- [ ] Screen ribbon was fed through the PCBA cutout.
- [ ] PCBA was pressed flush into the housing.
- [ ] Screen ribbon connector was opened, seated, and closed.
- [ ] Screen ribbon was tucked into the housing.
- [ ] Back housing was aligned around the on/off switch.
- [ ] Battery was pulled through the battery compartment opening.
- [ ] Front and back housings were fastened with tri-lobe screws.
- [ ] Battery was placed inside the battery compartment.
- [ ] Battery cover was installed and screwed shut.
- [ ] Knob bore was cleaned of excess filament.
- [ ] Knob was pressed onto the encoder until it clicked.
- [ ] Device was powered on and tested as per protocol.
