researchanddesire/Open-Source-Wireless-Remote_RADR/assembly-docs/index.mdx

---
title: RADR Wireless Remote Assembly Docs
license: CERN-OHL-S v2
---

Assembly documentation package for the RADR wireless remote.

## Assembly Package

- [PCB Overview](/radr/pcb-overview)
- [Bill of Materials](/radr/bom)
- [Assembly Guide](/radr/assembly-guide)

## Product Overview

RADR is a wireless remote built around a populated RADR PCB assembly, 2.0 inch SPI display, 800 mAh LiPo battery, printed front and back housings, printed buttons, printed power switch cover, printed rotary knob, weather stripping, and tri-lobe enclosure screws.

## Product Dimensions and Materials

Known material and part notes:

- Housing: FDM-printed RADR front and back housing.
- Display: 2.0 inch 14-pin SPI LCD display.
- Battery: 3.7 V 800 mAh LiPo battery.
- Fasteners: `BC-0408LTFB` tri-lobe screws.
- Cushioning: 2.5 cm piece of weather stripping installed on the PCBA.
