researchanddesire/Open-Source-Wireless-Remote_RADR/developer-docs/docs/hardware/getting-started.md

# RADR Hardware Getting Started

Use this section when you are assembling, repairing, or printing parts for RADR.

## Start Here

- [Printed Parts](/radr/hardware/printed-parts/)
- [PCB Overview](/radr/hardware/pcb/)
- [Battery and Power](/radr/hardware/specifications/battery-and-power/)
- [Feedback and Indicators](/radr/hardware/specifications/feedback-and-indicators/)
