researchanddesire/Open-Source-Wireless-Remote_RADR/hardware/pcb/RADR Schematic - OSSM Wireless V0.4.pdf

# Big Brain ESP32

## ESP32-S3-WROOM-1-N16R8

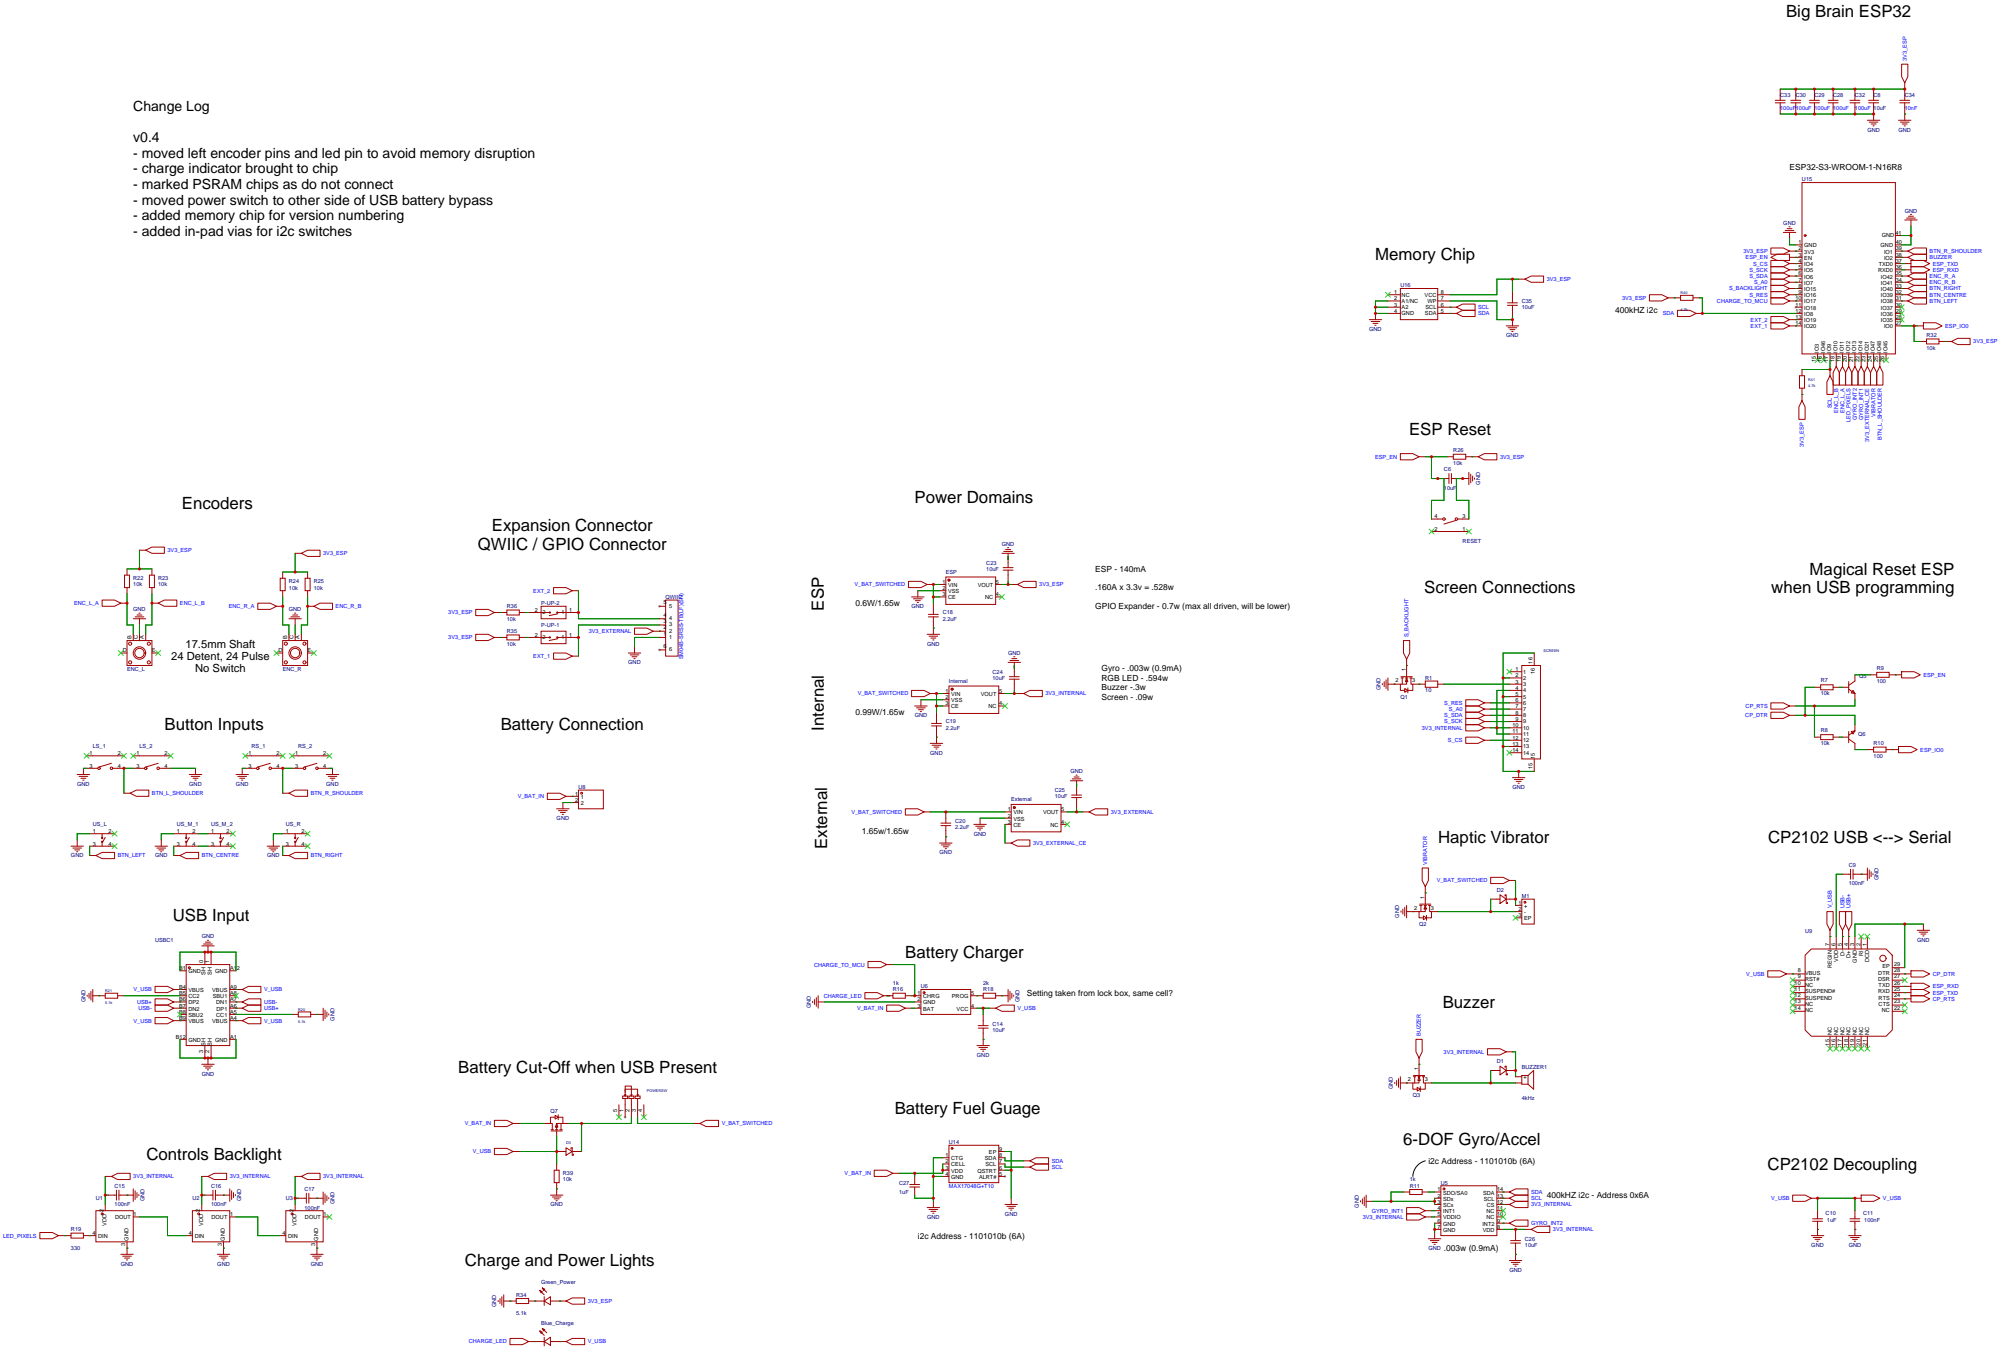
[picture p24: page 1]

Change Log
- moved left encoder pins and led pin to avoid memory disruption
- charge indicator brought to chip
- marked PSRAM chips as do not connect
- moved power switch to other side of USB battery bypass
- added memory chip for version numbering
- added in-pad vias for i2c switches

V_BAT_SWITCHED
GPIO Expander - 0.7w (max all driven, will be lower) 0.6W/1.65w

Setting taken from lock box, same cell?

Battery Cut-Off when USB Present

Charge and Power Lights
