researchanddesire/Open-Source-Wireless-Remote_RADR/(list of files, drawings)

Other design files:
hardware/pcb/RADR - PCB Design Files v0.4/Schematic - OSSM Wireless V0.4/1_Schematic - OSSM Wireless V0.4.schdoc
hardware/radr/Electronics/RADR - PCB Design Files v0.4/PCB - OSSM Wireless v0.4.pcbdoc
