researchanddesire/Open-Source-Wireless-Remote_RADR/src/constants.h

#pragma once

// Display dimensions
#define DISPLAY_WIDTH 320
#define DISPLAY_HEIGHT 240

// Display colors (using ST77XX color definitions)
#define COLOR_BLACK 0x0000
#define COLOR_WHITE 0xFFFF
#define COLOR_RED 0xF800
#define COLOR_GREEN 0x07E0
#define COLOR_BLUE 0x001F
#define COLOR_YELLOW 0xFFE0
#define COLOR_MAGENTA 0xF81F
#define COLOR_CYAN 0x07FF
#define COLOR_DARK_GREY 0x7BEF

// Display text sizes
#define TEXT_SIZE_SMALL 1
#define TEXT_SIZE_MEDIUM 2
#define TEXT_SIZE_LARGE 3

// Display margins and spacing
#define MARGIN_SMALL 10
#define MARGIN_MEDIUM 20
#define MARGIN_LARGE 40

// Progress bar dimensions
#define PROGRESS_BAR_WIDTH 20
#define PROGRESS_BAR_HEIGHT 180
