researchanddesire/Open-Source-Wireless-Remote_RADR/src/components/Icons.h

#ifndef ICONS_H
#define ICONS_H

#include <Arduino.h>

// 'link', 24x24px
static const unsigned char bitmap_link[] PROGMEM = {
    0x00, 0x00, 0x00, 0x00, 0x00, 0x00, 0x00, 0x03, 0xe0, 0x00, 0x0f, 0xf8,
    0x00, 0x1c, 0x38, 0x00, 0x38, 0x1c, 0x00, 0x00, 0x0c, 0x00, 0x00, 0x0c,
    0x00, 0x03, 0x0c, 0x00, 0x07, 0x1c, 0x04, 0x0e, 0x1c, 0x0e, 0x1c, 0x38,
    0x1c, 0x38, 0x70, 0x38, 0x70, 0x20, 0x38, 0xe0, 0x00, 0x30, 0xc0, 0x00,
    0x30, 0x00, 0x00, 0x30, 0x00, 0x00, 0x38, 0x1c, 0x00, 0x1c, 0x38, 0x00,
    0x1f, 0xf0, 0x00, 0x07, 0xc0, 0x00, 0x00, 0x00, 0x00, 0x00, 0x00, 0x00};
// 'link-broken', 24x24px
static const unsigned char bitmap_link_broken[] PROGMEM = {
    0x00, 0x00, 0x00, 0x00, 0xc0, 0x00, 0x00, 0xc1, 0xe0, 0x18, 0xc7, 0xf8,
    0x1c, 0xcf, 0x38, 0x0c, 0x1e, 0x1c, 0x00, 0x1c, 0x0c, 0x00, 0x00, 0x0c,
    0x78, 0x03, 0x1c, 0x78, 0x07, 0x38, 0x00, 0x0e, 0x78, 0x06, 0x1c, 0x70,
    0x0e, 0x38, 0x60, 0x1e, 0x70, 0x00, 0x1c, 0xe0, 0x1e, 0x38, 0xc0, 0x1e,
    0x30, 0x00, 0x00, 0x30, 0x38, 0x00, 0x38, 0x78, 0x30, 0x1c, 0xf3, 0x38,
    0x1f, 0xe3, 0x18, 0x07, 0x83, 0x00, 0x00, 0x03, 0x00, 0x00, 0x00, 0x00};
// 'blue-on', 24x24px
static const unsigned char bitmap_ble_on[] PROGMEM = {
    0x00, 0x00, 0x00, 0x00, 0x18, 0x00, 0x00, 0x1c, 0x00, 0x00, 0x1f, 0x00,
    0x00, 0x1f, 0x80, 0x00, 0x1b, 0xc0, 0x06, 0x18, 0xe0, 0x07, 0x18, 0xe0,
    0x03, 0xdb, 0xc0, 0x01, 0xff, 0x80, 0x00, 0xff, 0x00, 0x00, 0x3c, 0x00,
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
    0x00, 0x00, 0x30, 0x00, 0x00, 0x01, 0x80, 0x00, 0x01, 0xc0, 0x00, 0x00, 0xe0, 0x00, 0x00, 0x70,
    0x1f, 0xff, 0xf8, 0x1f, 0xff, 0xf8, 0x00, 0x00, 0x70, 0x00, 0x00, 0xe0, 0x00, 0x01, 0xc0, 0x00,
    0x01, 0x80, 0x00, 0x00, 0x00, 0x00, 0x00, 0x00};

#endif // OLED_1IN54_ICONSSMALL_H
