researchanddesire/Open-Source-Wireless-Remote_RADR/src/components/DisplayObject.h

#ifndef DISPLAYOBJECT_H
#define DISPLAYOBJECT_H

#include <Adafruit_GFX.h>

class DisplayObject {
  protected:
    int16_t x, y;
    int16_t width, height;
    bool isDirty = false;
    long lastDrawTime = 0;

  public:
    DisplayObject(int16_t x, int16_t y, int16_t width, int16_t height)
        : x(x), y(y), width(width), height(height) {}

    bool isFirstDraw = true;

    virtual ~DisplayObject() {}

    virtual bool shouldDraw() {
        // Only redraw every 2 seconds by default, or if it's the first draw
        return isFirstDraw || (millis() - lastDrawTime > 2000);
    }
    virtual void draw() = 0;

    void tick() {
        isDirty |= shouldDraw();
        isDirty |= isFirstDraw;

        if (!isDirty) {
            return;
        }
        draw();

        isFirstDraw = false;
        isDirty = false;
        lastDrawTime = millis();  // Update lastDrawTime when we actually draw
    }

    // Getters
    int16_t getX() const { return x; }
    int16_t getY() const { return y; }
    int16_t getWidth() const { return width; }
    int16_t getHeight() const { return height; }
};

#endif
