researchanddesire/Open-Source-Wireless-Remote_RADR/(commit log)

2026-06-10 OSS prep: hardware/radr layout, ota/, developer-docs from Software/
    Align to RAD template — Hardware→hardware/radr, docs→ota, migrate
    Mintlify Software/ to developer-docs/, OTA-only Pages workflow.
2026-06-10 Add ota/index.html for GitHub Pages root
    RADR OTA site lacked a landing page after docs→ota rename.
2026-06-11 docs(developer-docs): add hardware tree, tools, and license from user docs
    Add the full hardware/ tree (PCB, printed-parts, specifications, BOM),
    tools/web-flasher, and the CERN-OHL-S license migrated from the
    non-technical simple-docs site, with nav wired into mkdocs.yml and .pages.
    (cherry picked from commit ca509d8d54530e773521e8ecd24c346d87bcee25)
2026-06-12 Adopt RAD BOM standard (schema + bom-lint + agent rule) (#2)
    * Adopt RAD BOM standard: schema, agent rule, bom-lint
    Mirror the ossm reference implementation:
    - vendor canonical bom.schema.json from dev-docs (read-only)
    - hardware/radr/bom.csv on the standard header (legacy xlsx to migrate)
    - .cursor/rules/bom.mdc for agents
    - bom-lint workflow + stdlib validator; sync-bom-schema from dev-docs
    - BOM standard links in CONTRIBUTING; new hardware issue form + PR template
    * Move vendored BOM schema next to bom-lint script (CI tooling, not hardware)
    * Clarify bom.csv is freely human-editable as lon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
2026-06-12 Add BTY (Battery) part category from BOM standard (#4)
2026-06-12 BOM standard: add FDM category; permissive source rule (#5)
2026-06-15 Add RADR assembly docs
2026-06-15 Use PCB Overview assembly page
2026-06-15 Update RADR hardware BOM
2026-06-16 Standardize Ohai assembly docs package
2026-09-04 Route assembly content synchronization through rad-app
2026-09-04 Seed RADR assembly content from rad-app
    Initialize from researchanddesire/rad-app@1b2e12f7bdef4b8d276ca5f5a015a55d3f347ee2.
    English-only radr content, shared product assets and BOM snapshots; .en is removed from page/metadata filenames.
2026-09-04 Avoid firmware releases for assembly-only changes (#11)
2026-10-11 Open OSSM machine settings from the Menu button
    On the OSSM control screens, Menu is now lit when the OSSM is paused or at
    speed 0 and opens a machine-geometry settings list. Pressing it while grey
    shows "Pause First" for 1.5 s instead of doing nothing. Edits stay local
    until the confirm screen's Restart writes them over RAD BLE (control lease
    acquired and released around the writes) and restarts the OSSM; Cancel
    drops them. Older OSSM firmware shows "Update OSSM to change settings".
    - Subscribe to the RAD BLE response characteristic (indications) and add
    an OSSM RAD BLE client with id matching and a 2 s timeout
    - Native-tested logic for requests, replies, geometry validation (mirrors
    t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
2026-10-20 Add RADR assembly documentation
    Copied unchanged from __legacy_RADR-OSS@4f001a5d19757f085a5db8356882272593ae8673, the previous assembly documentation source.
2026-10-20 Notify the documentation hub from main
    The hub now reads RADR assembly docs from this repository, main only.
2026-10-20 Remove GitHub Pages and retired docs sync files
    Production releases now publish only to Supabase: the verified immutable
    release and the master and production aliases. The Pages bridge, the
    ota/ payload (0.0.x builds, kept in history), and its maintenance script
    are removed.
    Drop the retired assembly checkpoint and the dev-docs rebuild dispatch,
    which nothing consumes, and record the current hub contract in AGENTS.md.
2026-10-20 Point RADR assembly docs at the canonical repository
    Repoint the nine hardware links and the BOM source marker from the private RADR-OSS repository to Open-Source-Wireless-Remote_RADR, whose hardware/ layout now matches. bom.json is regenerated from bom.csv with the new source fields.
2026-10-20 Gate rig validation on firmware changes and post video evidence
    * Gate rig validation on firmware changes and post video evidence
    - PR target policy: firmware changes enter staging first unless they come
    from a fix/<issue> branch; every other change may target main directly.
    - PR firmware validation runs the build and Test Rig only when the firmware
    directory or the validation tooling changes; Build validation and Hardware
    validation pass without work otherwise. Title and body edits no longer
    start a second rig run.
    - Hardware evidence comments on the PR with each device's rig video, a GIF
    preview and the result, pass or fail, stored in the private hil-evidence
    bucket of Supabas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
2026-10-28 Move software into software/firmware, scripts and dev
    - software/firmware/ is the PlatformIO project formerly at the repository
    root, including config/, data/ and ButtplugIO/.
    - software/scripts/ holds the conversion, release, capture and rig tooling.
    - software/dev/ is reserved for local development services.
    - Workflows, firmware path filters, editor rules and docs follow the new
    paths.
2026-11-10 Fix Lovense connections running out of memory and add a Lovense emulator
    RADR could not connect to a Lovense toy: the Buttplug factory built the
    device, which starts its connection task at once, while the parsed
    registry and protocol files were still held in internal RAM. On the Test
    Rig that left 476 bytes free, so the 10.8 KB task stack could not be
    allocated and Select did nothing.
    - Parse the Buttplug registry and protocol files into PSRAM, straight from
    the file, and release them before the device is created.
    - Stop asking a silent toy for DeviceType after 5 seconds instead of
    blocking the connection forever.
    - Send Vibrate:0 before RADR drops the link, so a toy is never left runni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
2026-11-11 Keep the device registry out of internal RAM
    The registry was an unordered_map of 92 service UUID strings: about
    10.5 KB of internal RAM in roughly 180 small blocks. With Wi-Fi and BLE
    running, that left no free internal block large enough for the BLE
    connection task's 10,840-byte stack, so no device could be connected.
    The registry is now one table in PSRAM. On the Test Rig the largest free
    internal block after boot went from 10,228 to 22,516 bytes, and with a
    RAD BLE client attached and a scan finished from about 10 KB to 16 KB.
    registry.json is parsed straight from the file into PSRAM, which also
    removes a 0.9 s delay from boot.
2026-11-11 Wait for internal RAM before giving up on a device connection
    The BLE connection task needs one 10,840-byte block of internal RAM. Other
    short-lived users take that block for a second or two: the scan monitor
    stack during a scan, and in staging builds the hardware observer's HTTPS
    check every 30 seconds. A connection requested at that moment failed with
    "Out of memory" although the memory was free again right after.
    The connection task is now created with createInternalTaskWithWait(),
    which waits up to 4 seconds for a large enough block. The stack stays in
    internal RAM because device code reads LittleFS on this task.
